mrsandipandas/Master_Thesis_Deliverables/README.md

# Master Thesis
Master Thesis Deliverables: Active Polarization Rotator (KTH-Micro and Nano Systems).

Author: Sandipan Das (sandipan@kth.se).

Supervisors: Carlos Errando Herranz(carloseh@kth.se), Phd Student at KTH, Sweden and Prof. Norvald Stol(norvald.stol@item.ntnu.no), NTNU, Norway.
             
Examiner:  Prof. Kristinn B. Gylfason(kristinn.gylfason@ee.kth.se), KTH, Sweden.

Please contact me at sandipan@kth.se if you want me to add anything.
