mrsandipandas/Master_Thesis_Deliverables/2-Thesis_Draft/Ch0.2-Title/title.tex

\documentclass[../report.tex]{subfiles}
\begin{document}	
    \begin{titlepage}
        \thispagestyle{empty}
        \begin{center}
            \\
            \vspace{2.5cm}
	            \huge{Silicon photonics based MEMS tunable}
	        \begin{adjustwidth*}{-0.1cm}{-0.1cm}
	        	\huge{polarization rotator for optical communications}\\
		    \end{adjustwidth*}
            \vspace{4cm}
            \Large{\textbf{Sandipan Das}}\\
            \vspace{4cm}
            \Large{Stockholm, \today}
        \end{center} 
        %\begin{tabular}{ll} 
        %\noindent Author: &Sandipan Das (sandipan@kth.se) \\
        %\noindent Supervisors: & Carlos Errando Herranz (carloseh@kth.se), Phd Student at %KTH, Sweden \\ 
        %					   & Prof. Norvald Stol (norvald.stol@item.ntnu.no), NTNU, Norway\\[6ex]
        %													
        %\indent Examiner:  &Prof. Kristinn B. Gylfason (kristinn.gylfason@ee.kth.se), KTH, Sweden\\ 
        %
        %\end{tabular}
    \end{titlepage}
    %Empty page inserted for making print ready 
    %\thispagestyle{empty}
    %\cleardoublepage
\end{document}
