mrsandipandas/Master_Thesis_Deliverables/2-Thesis_Draft/Ch9-Appendix/glossary.tex

\documentclass[../report.tex]{subfiles}
\begin{document}	
	
	\newacronym{iot}{IoT}{Internet of Things}
	\newacronym{ims}{IMS}{IP Multimedia Subsystem}
	\newacronym{ic}{IC}{Integrated Circuit(s)}
	\newacronym{ict}{ICT}{Information and Communication Technology}
	\newacronym{cmos}{CMOS}{Complementary Metal-Oxide Semiconductor}
	\newacronym{soi}{SOI}{Silicon on Insulator}
	\newacronym{ri}{RI}{Refractive index}
	\newacronym{mems}{MEMS}{Microelectromechanical systems}
	\newacronym{cagr}{CAGR}{Compound Annual Growth Rate}
	\newacronym{pmd}{PMD}{polarization mode dispersion}
	\newacronym{pdl}{PDL}{polarization dependent loss}
	\newacronym{pdw}{PD$\lambda$}{polarization dependent wavelength characteristics}
	\newacronym{per}{PER}{Polarization extinction ratio}
	\newacronym{pr}{PR}{Polarization Rotator}
	\newacronym{tpr}{TPR}{Tunable Polarization Rotator}
	\newacronym{tpps}{TPPS}{Tunable polarization phase shifters}
	\newacronym{sop}{SOP}{state of polarization}
	\newacronym{oeic}{OEIC}{Optoelectronic Integrated Circuit(s)}	
	\newacronym{pbg}{PBG}{Photonic band-gap}
	\newacronym{em}{EM}{Electromagnetic}
	\newacronym{tem}{TEM}{Tansverse Electromagnetic}
	\newacronym{te}{TE}{Transverse Electric}
	\newacronym{tm}{TM}{Transverse Magnetic}
	\newacronym{fem}{FEM}{Finite element method}
	\newacronym{bpm}{BPM}{Beam propagation method}
	\newacronym{fit}{FIT}{Finite integration technique}
	\newacronym{fdtd}{FDTD}{Finite difference time domain}
	\newacronym{smc}{SMC}{Single-mode condition}	
	\newacronym{rf}{RF}{Radio frequency}
	\newacronym{fom}{FOM}{figures of merit}	
	\newacronym{il}{IL}{Insertion loss}
	\newacronym{hsq}{HSQ}{Hydrogen silsesquioxane}
	\newacronym{zep}{ZEP}{ZEP7000}
	\newacronym{pbs}{PBS}{Polarization Beam Splitter}
	\newacronym{nlc}{NLC}{Nematic liquid crystals}
	\newacronym{sem}{SEM}{Scanning electron microscope}				
	
\end{document}

%from documentation
%\newacronym[⟨key-val list⟩]{⟨label ⟩}{⟨abbrv ⟩}{⟨long⟩}
%above is short version of this
% \newglossaryentry{⟨label ⟩}{type=\acronymtype,
% name={⟨abbrv ⟩},
% description={⟨long⟩},
% text={⟨abbrv ⟩},
% first={⟨long⟩ (⟨abbrv ⟩)},
% plural={⟨abbrv ⟩\glspluralsuffix},
% firstplural={⟨long⟩\glspluralsuffix\space (⟨abbrv ⟩\glspluralsuffix)},
% ⟨key-val list⟩}

% If you want to link acronym and glossary: (http://tex.stackexchange.com/questions/8946/how-to-combine-acronym-and-glossary)
%\newglossaryentry{apig}{
%	name={API},
%	description={An Application Programming Interface (API) desc}}
%\newglossaryentry{api}{
%	type=\acronymtype, 
%	name={API}, 
%	description={Application Programming Interface}, 
%	first={Application Programming Interface (API)\glsadd{apig}}, 
%	see=[Glossary:]{apig}}
