mrsandipandas/Master_Thesis_Deliverables/3-Administrative_Stuffs/Thesis_topic_form_Sandipan_Das.pdf

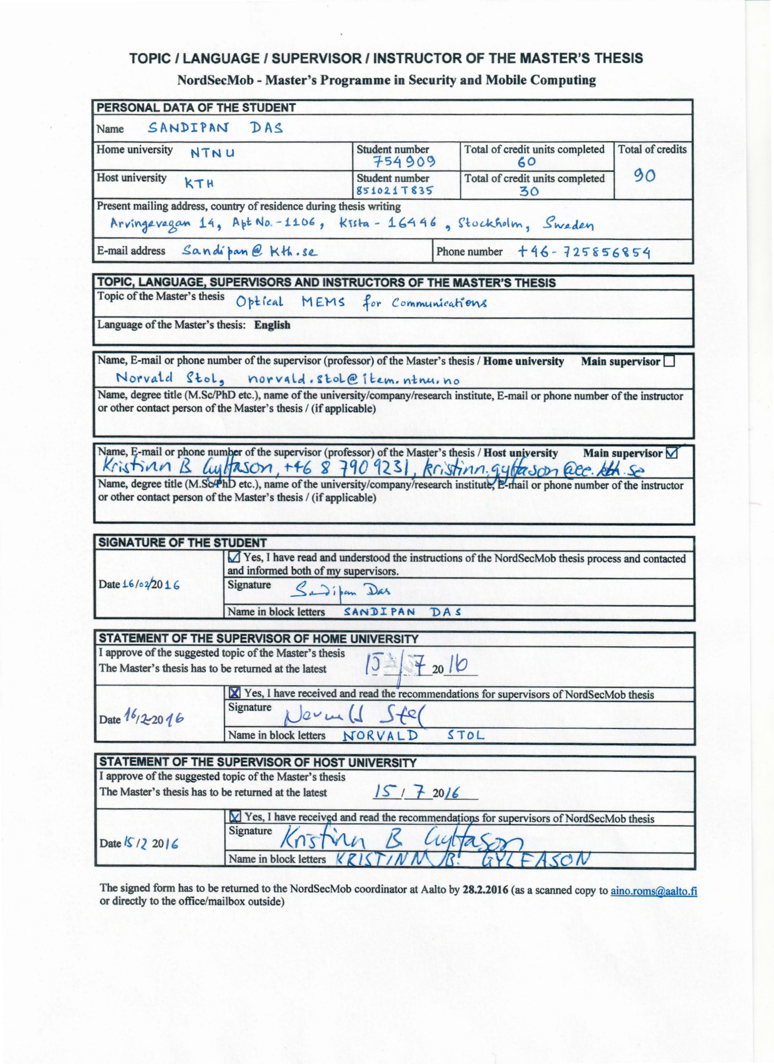
[picture p69: page 1]
