mrsandipandas/Master_Thesis_Deliverables/3-Administrative_Stuffs/Sandipan_Thesis_Application_KTH.pdf

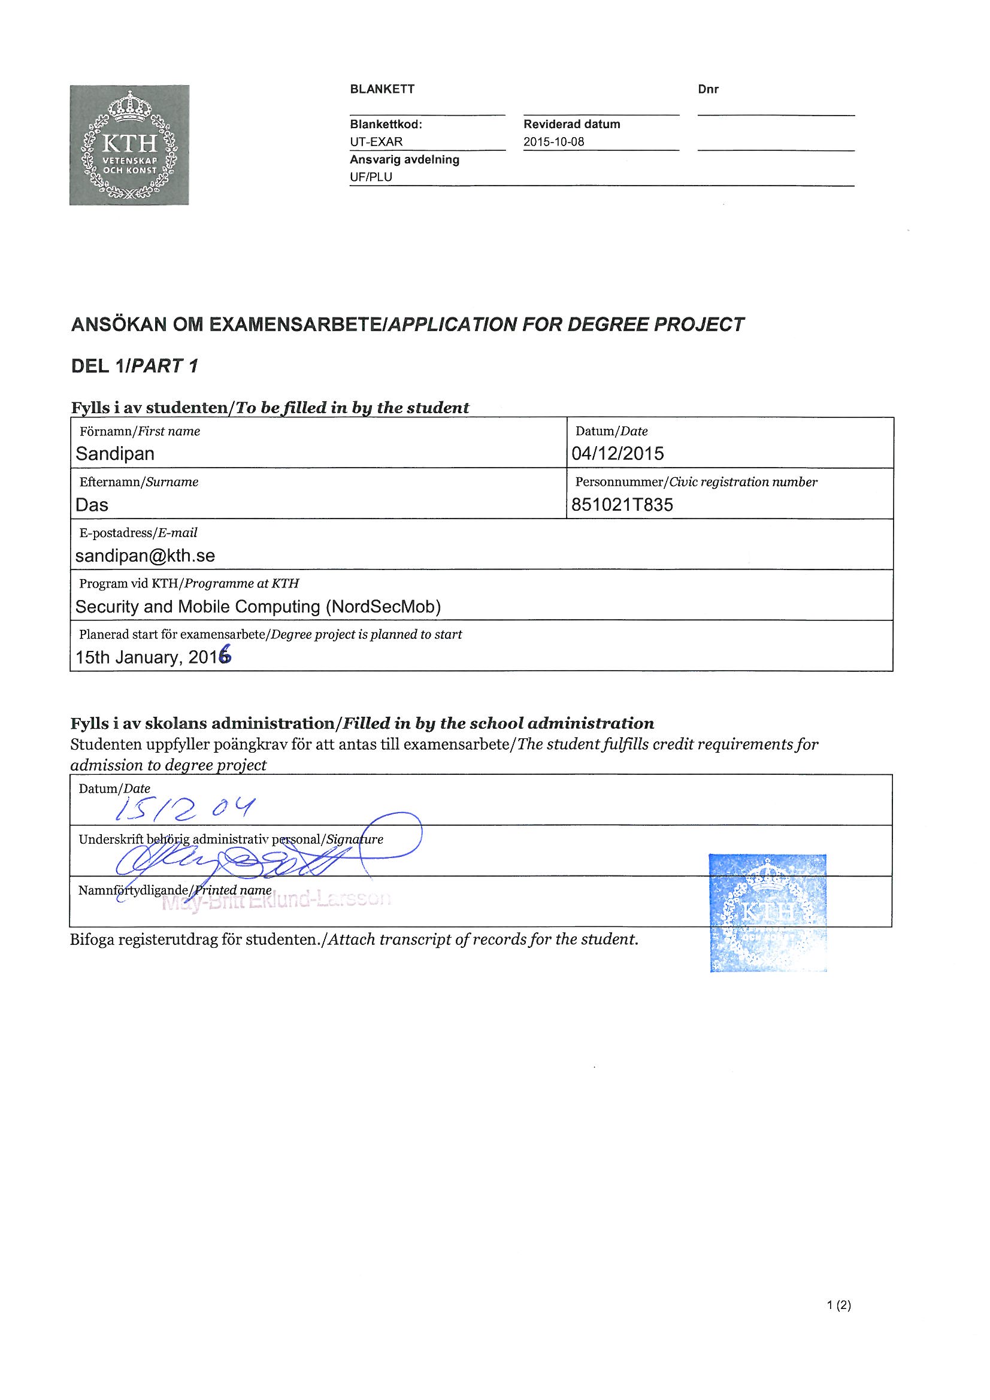
[picture p70: page 1]
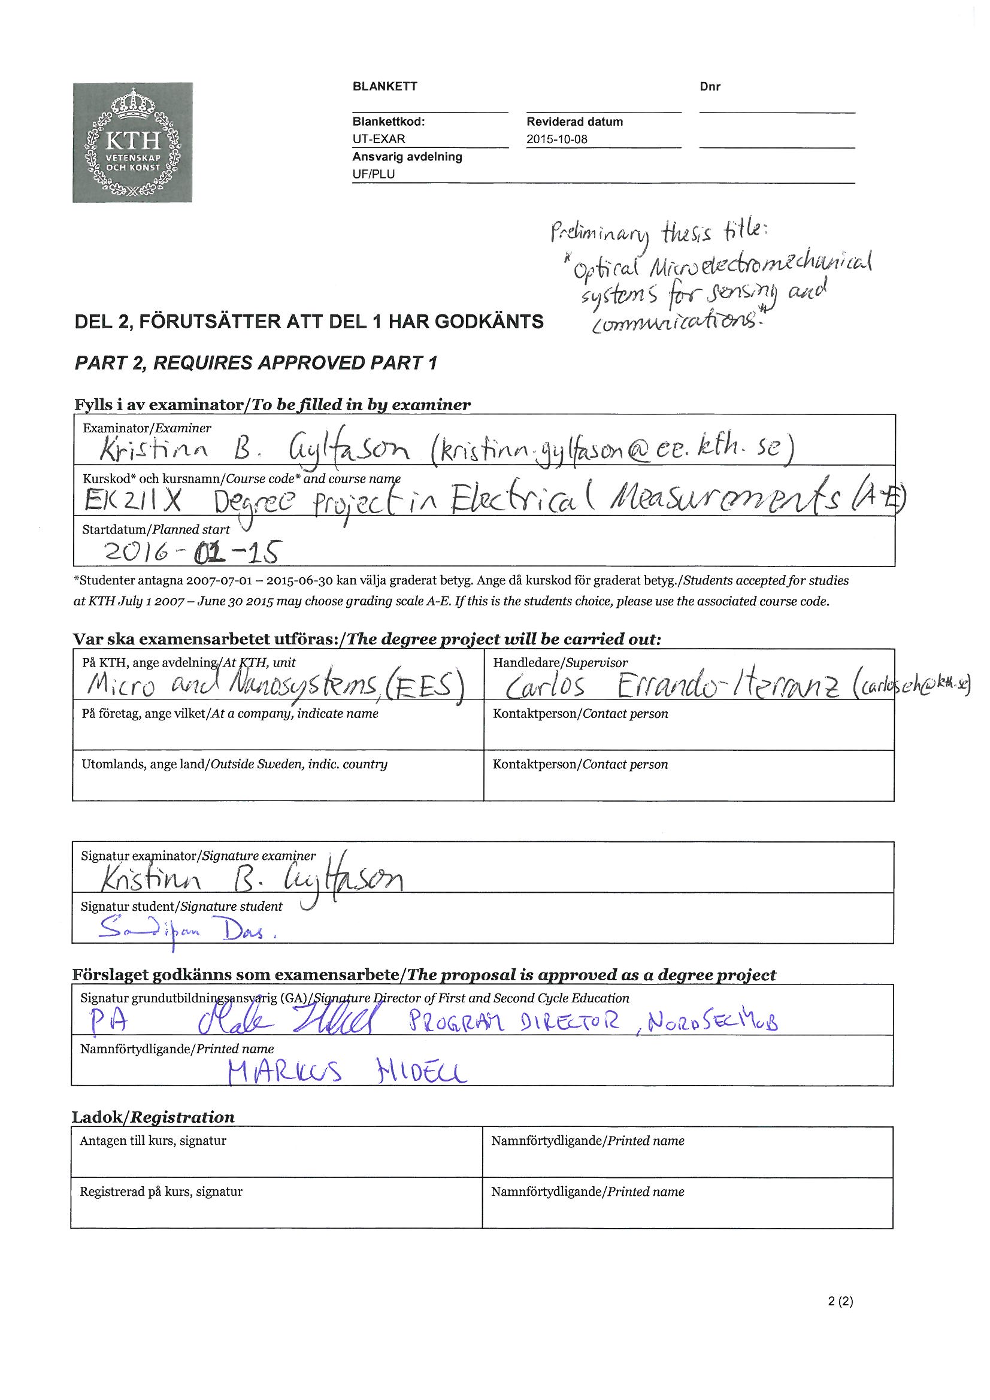
[picture p71: page 2]
