mrsandipandas/Master_Thesis_Deliverables/2-Thesis_Draft/images/pbs.xlsx

Sheet: Core_Waveguide
W_core | TE3 | TM0 | TE1 | TE0
0.30 |  | 1.046154935 |  | 1.381686723
0.32 |  | 1.058032549 |  | 1.563106257
0.34 |  | 1.071198884 |  | 1.724267958
0.36 |  | 1.084958105 |  | 1.858616204
0.38 |  | 1.100499861 |  | 1.972435758
0.40 |  | 1.116521359 | 1.00009847 | 2.065189521
0.42 |  | 1.13307403 | 1.006582029 | 2.143141025
0.44 |  | 1.14999511 | 1.015379584 | 2.209222711
0.46 |  | 1.167137372 | 1.027066121 | 2.265720223
0.48 |  | 1.184308295 | 1.042497707 | 2.314488018
0.50 |  | 1.201169659 | 1.063748212 | 2.357562383
0.52 |  | 1.217935834 | 1.092673078 | 2.394645587
0.54 |  | 1.234299599 | 1.132882844 | 2.427330579
0.56 |  | 1.250202855 | 1.188164109 | 2.456283939
0.58 |  | 1.260243649 | 1.265600932 | 2.48204625
0.60 |  | 1.280419918 | 1.346141434 | 2.505077123
0.62 |  | 1.294498793 | 1.441165934 | 2.526119869
0.64 |  | 1.308125381 | 1.533684198 | 2.544802484
0.66 |  | 1.321154999 | 1.621327276 | 2.561708667
0.68 |  | 1.333557361 | 1.702174468 | 2.577051142
0.70 |  | 1.345385022 | 1.775892896 | 2.591027862
0.72 |  | 1.356692886 | 1.84276953 | 2.603787412
0.74 |  | 1.367265523 | 1.904735656 | 2.615710186
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
