mrsandipandas/Master_Thesis_Deliverables/2-Thesis_Draft/images/1-voice-traffic-forecast.jpeg

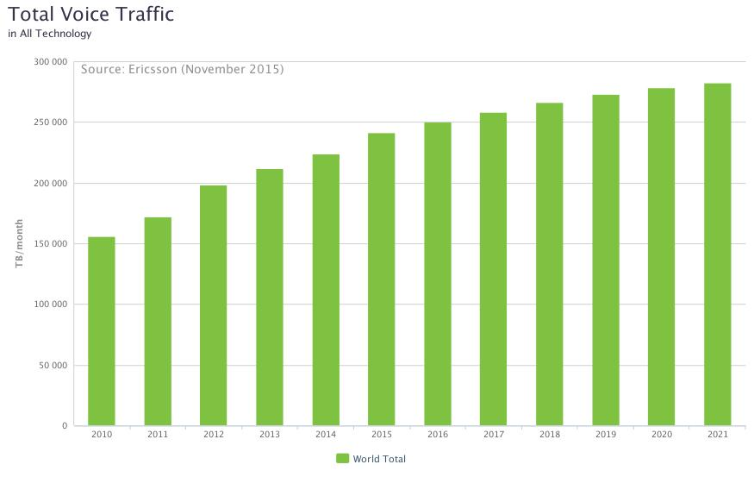
2-Thesis_Draft/images/1-voice-traffic-forecast.jpeg
