mrsandipandas/Master_Thesis_Deliverables/2-Thesis_Draft/images/2-random-pol.jpg

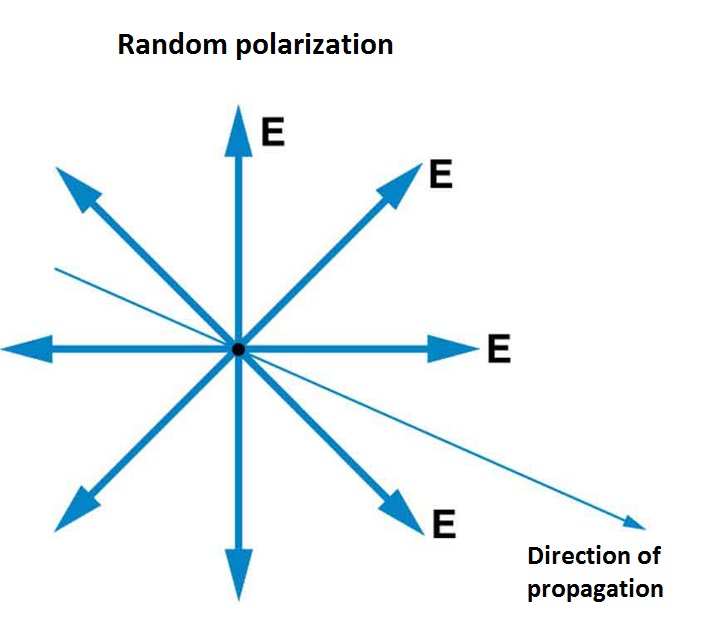
2-Thesis_Draft/images/2-random-pol.jpg
