mrsandipandas/Master_Thesis_Deliverables/2-Thesis_Draft/images/2-te-tm-mode.png

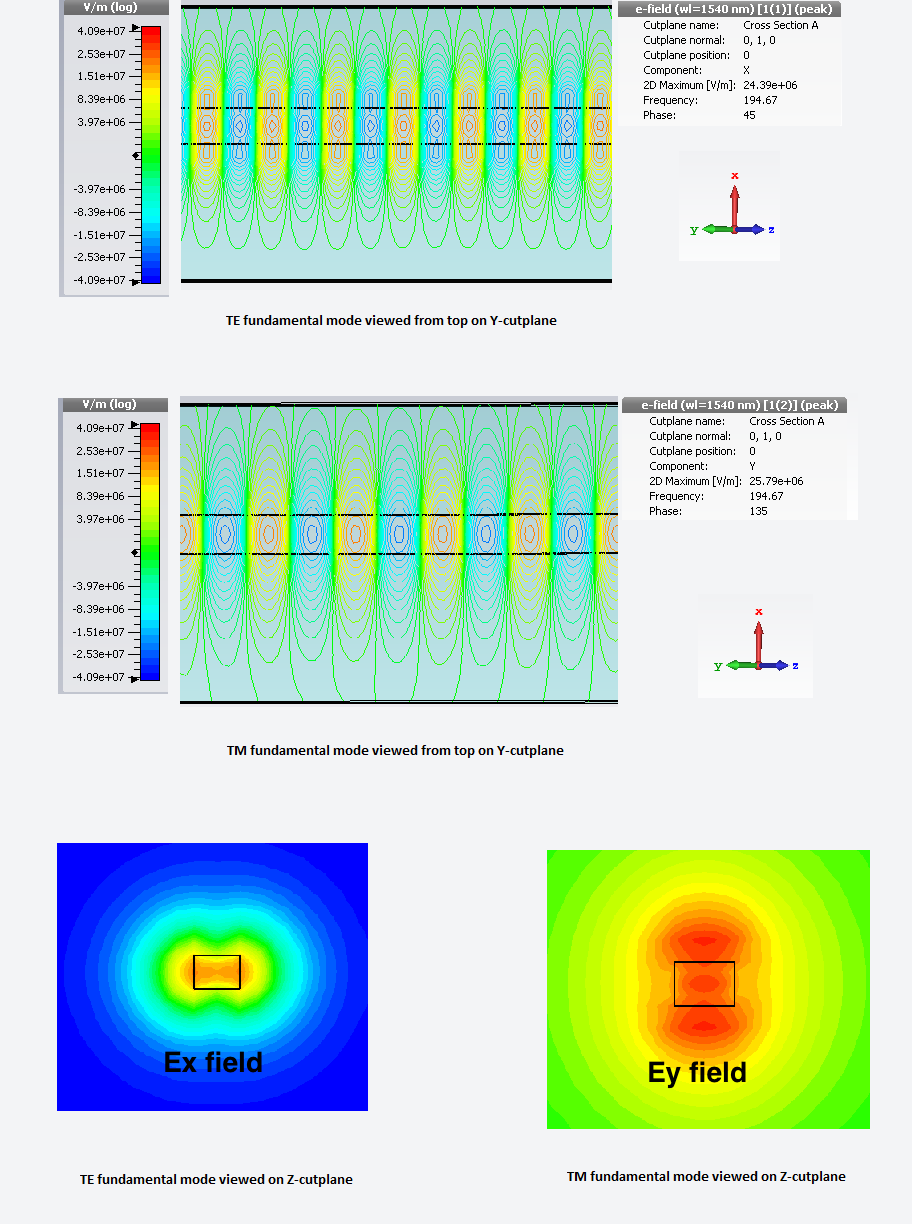
2-Thesis_Draft/images/2-te-tm-mode.png
