mrsandipandas/Master_Thesis_Deliverables/2-Thesis_Draft/images/4-tm-silica-cladding-700nm.png

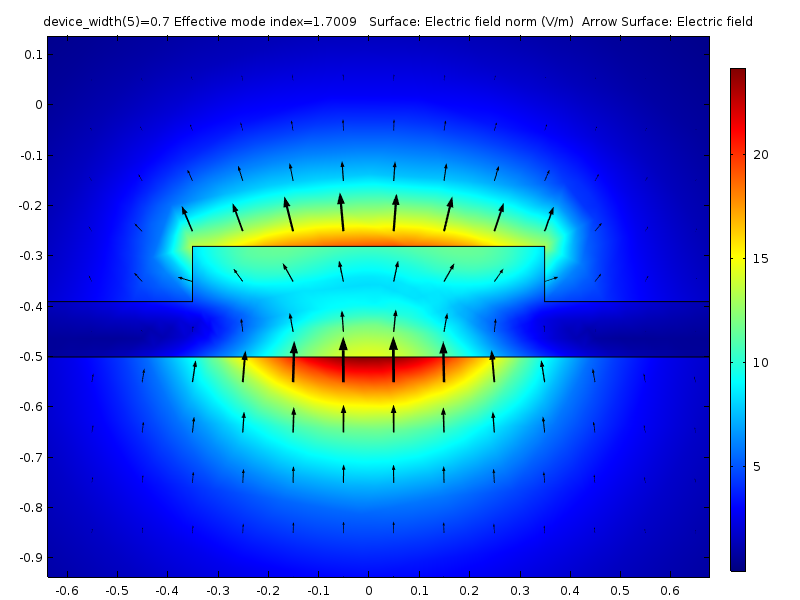
2-Thesis_Draft/images/4-tm-silica-cladding-700nm.png
