mrsandipandas/Master_Thesis_Deliverables/4-Current_work/General_idea_coupling_to_avoid_going_to_PR/c1.png

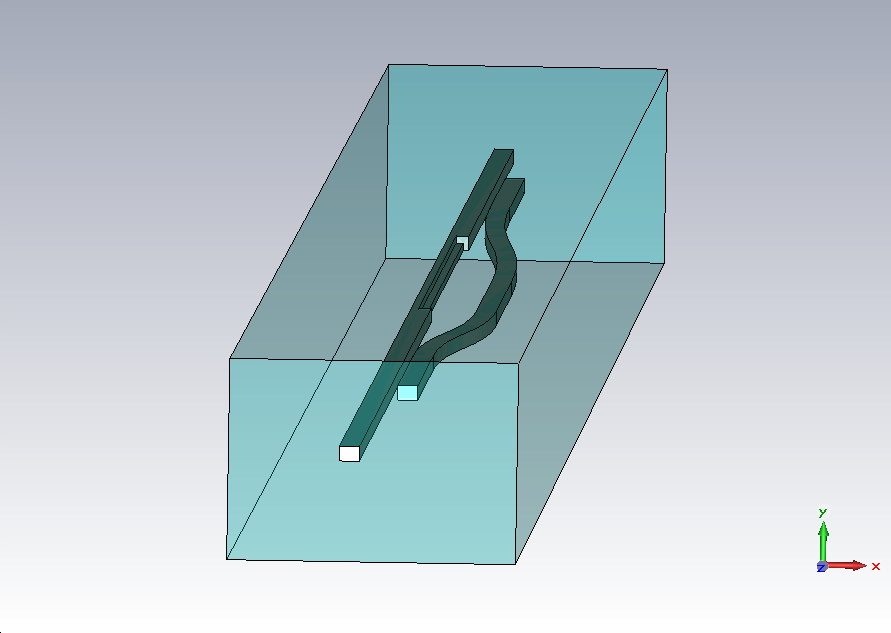
4-Current_work/General_idea_coupling_to_avoid_going_to_PR/c1.png
