mrsandipandas/Master_Thesis_Deliverables/4-Current_work/Idea_1/PR Design/1.bmp

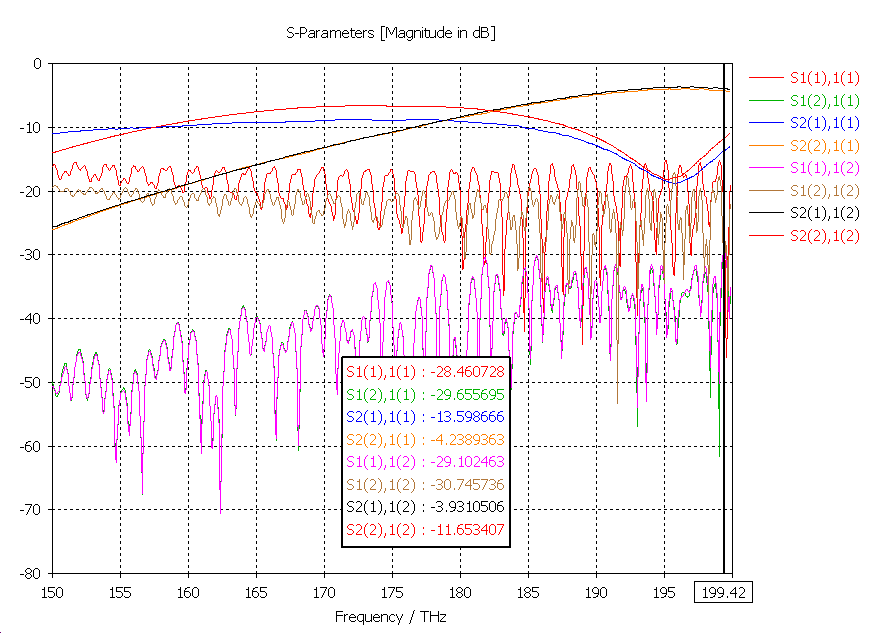
4-Current_work/Idea_1/PR Design/1.bmp
