mrsandipandas/Master_Thesis_Deliverables/4-Current_work/Idea_1/PR Design/wg.png

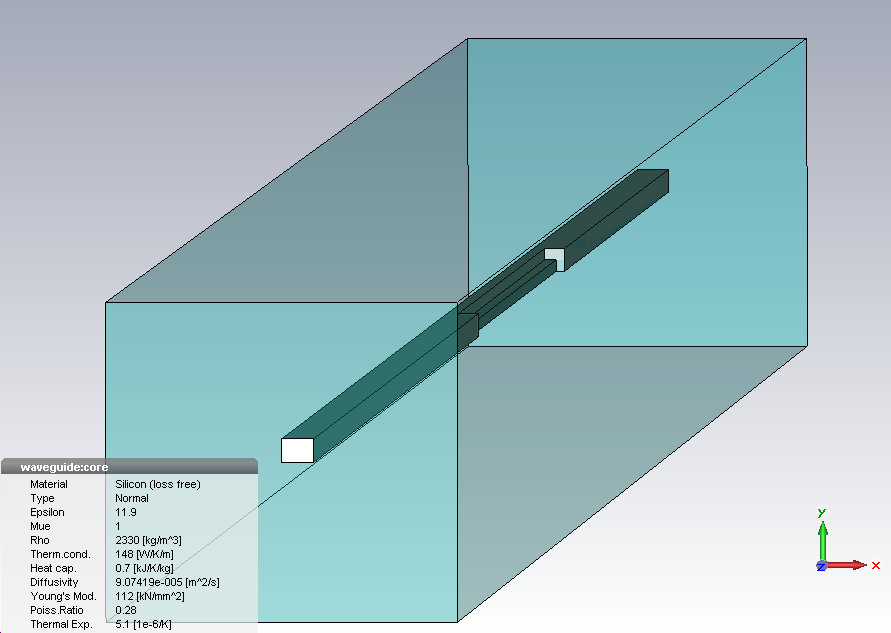
4-Current_work/Idea_1/PR Design/wg.png
