mrsandipandas/Master_Thesis_Deliverables/4-Current_work/Idea_1/PR With MEMS/stair_coupler.bmp

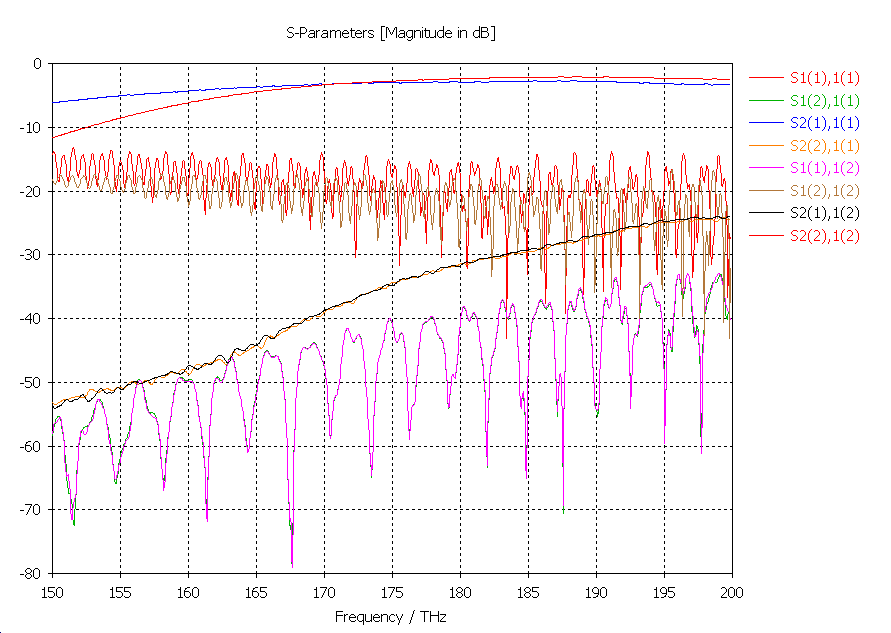
4-Current_work/Idea_1/PR With MEMS/stair_coupler.bmp
