mrsandipandas/Master_Thesis_Deliverables/4-Current_work/Idea_1/PR With MEMS/wg_with_coupling.png

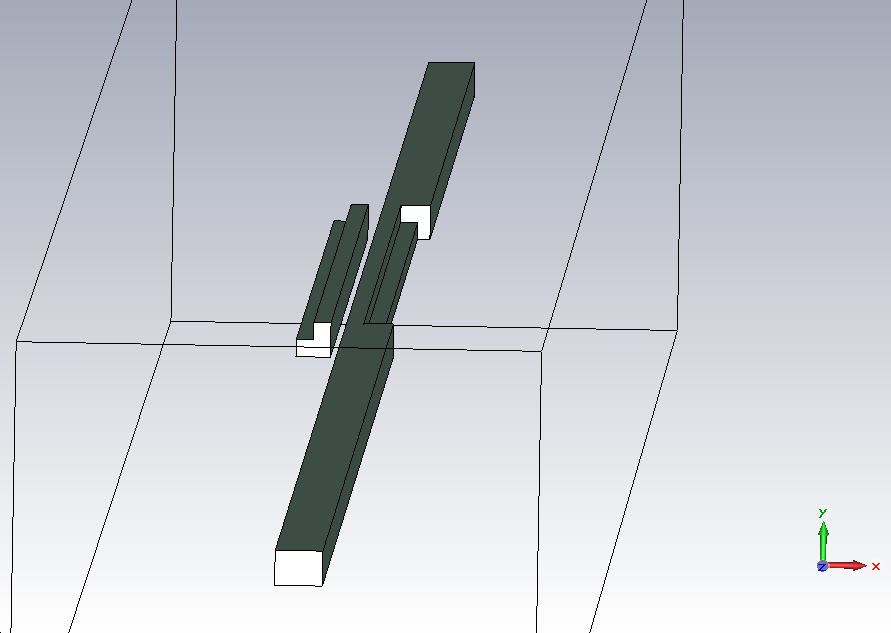
4-Current_work/Idea_1/PR With MEMS/wg_with_coupling.png
