mrsandipandas/Master_Thesis_Deliverables/4-Current_work/Idea_2/PR Design/s.bmp

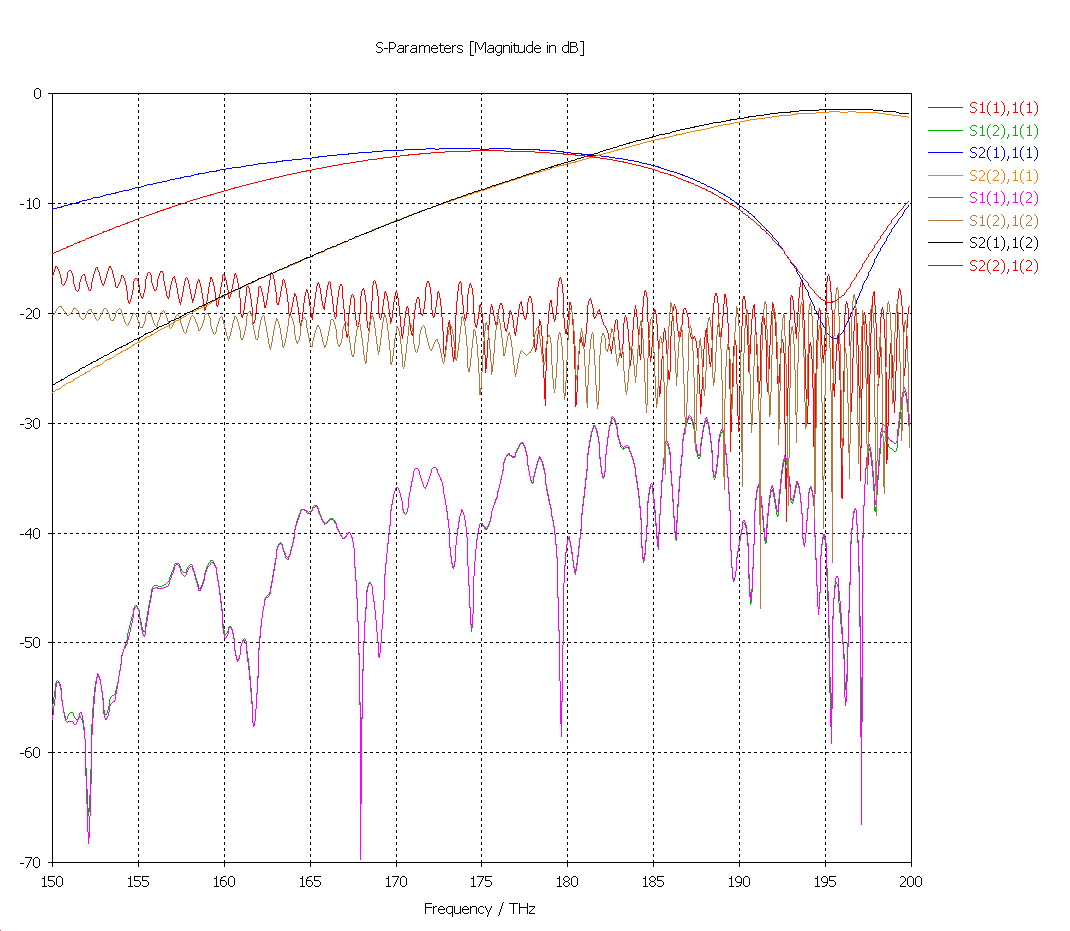
4-Current_work/Idea_2/PR Design/s.bmp
