mrsandipandas/Master_Thesis_Deliverables/4-Current_work/Idea_2/PR Design/simplewg.png

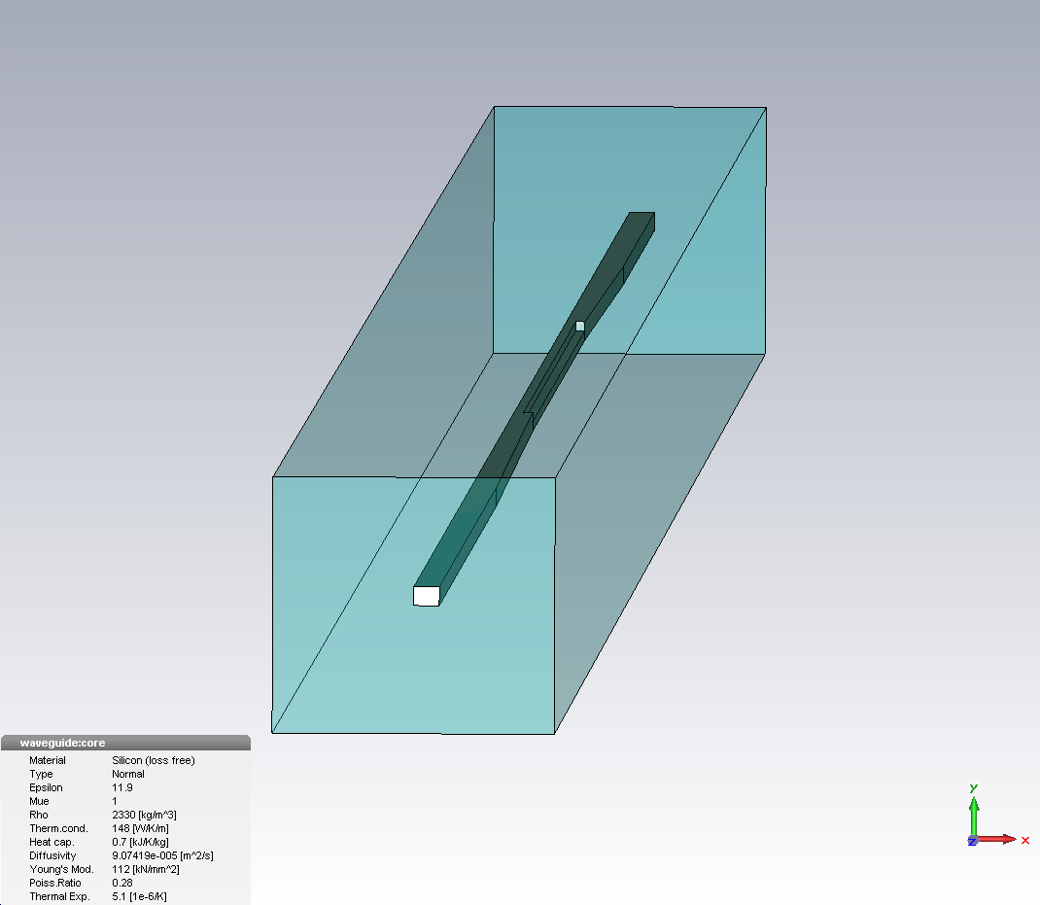
4-Current_work/Idea_2/PR Design/simplewg.png
