mrsandipandas/Master_Thesis_Deliverables/4-Current_work/Idea_2/PR With MEMS/s.bmp

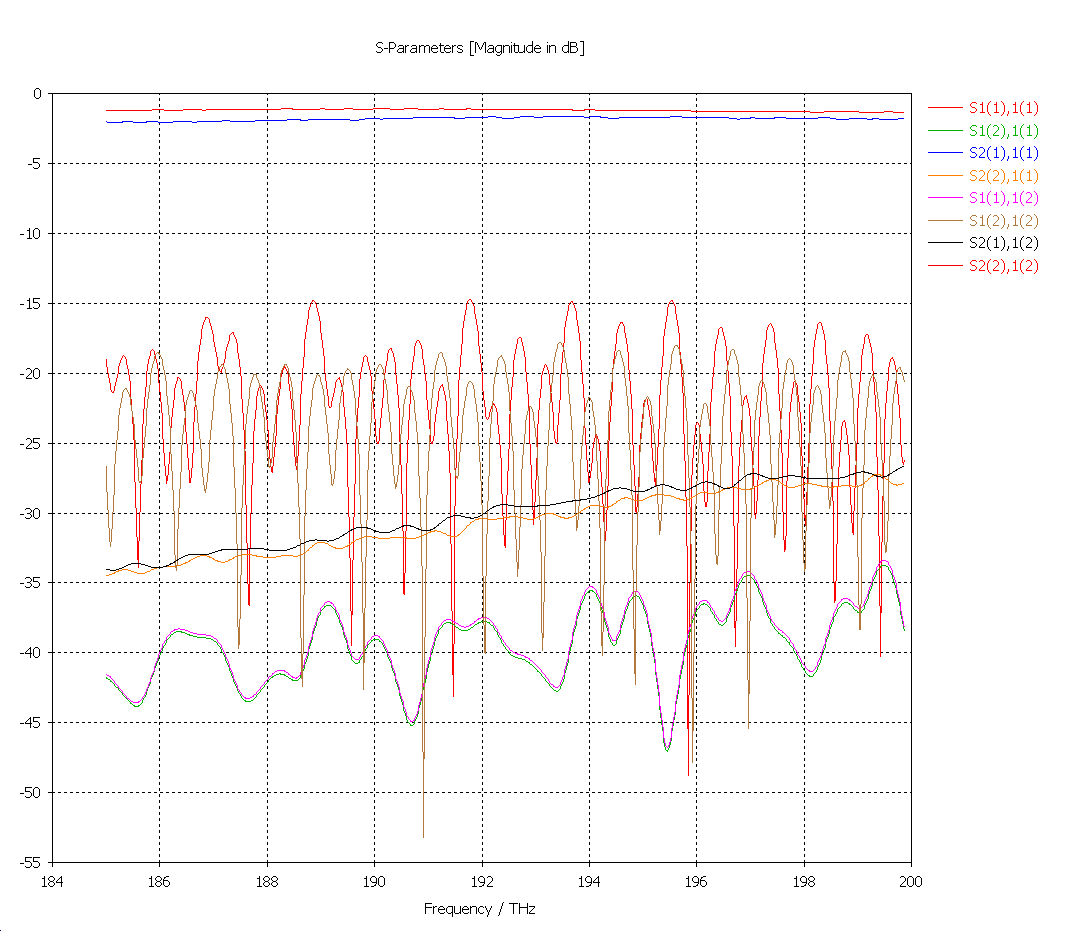
4-Current_work/Idea_2/PR With MEMS/s.bmp
