mrsandipandas/Master_Thesis_Deliverables/4-Current_work/Mode_evolution_double_taper/s.bmp

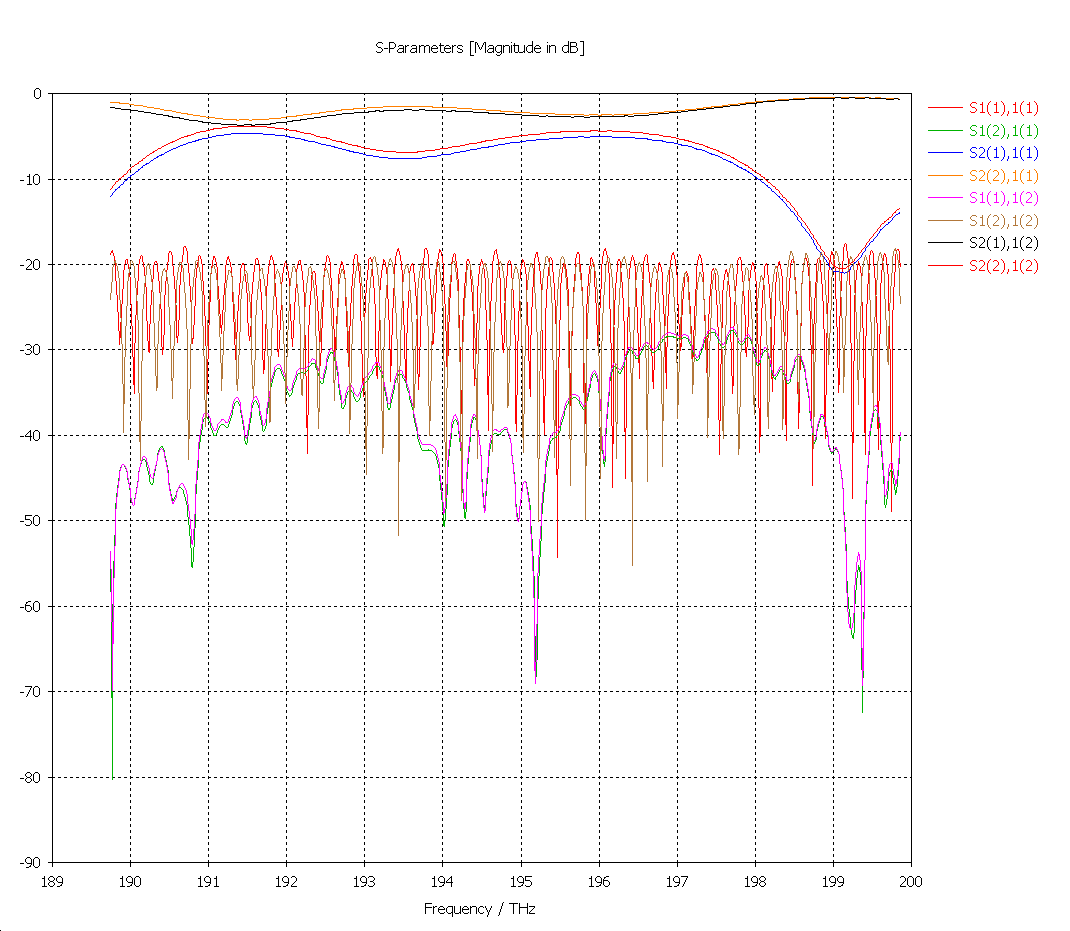
4-Current_work/Mode_evolution_double_taper/s.bmp
