mrsandipandas/Master_Thesis_Deliverables/4-Current_work/Mode_evolution_double_taper/wg.png

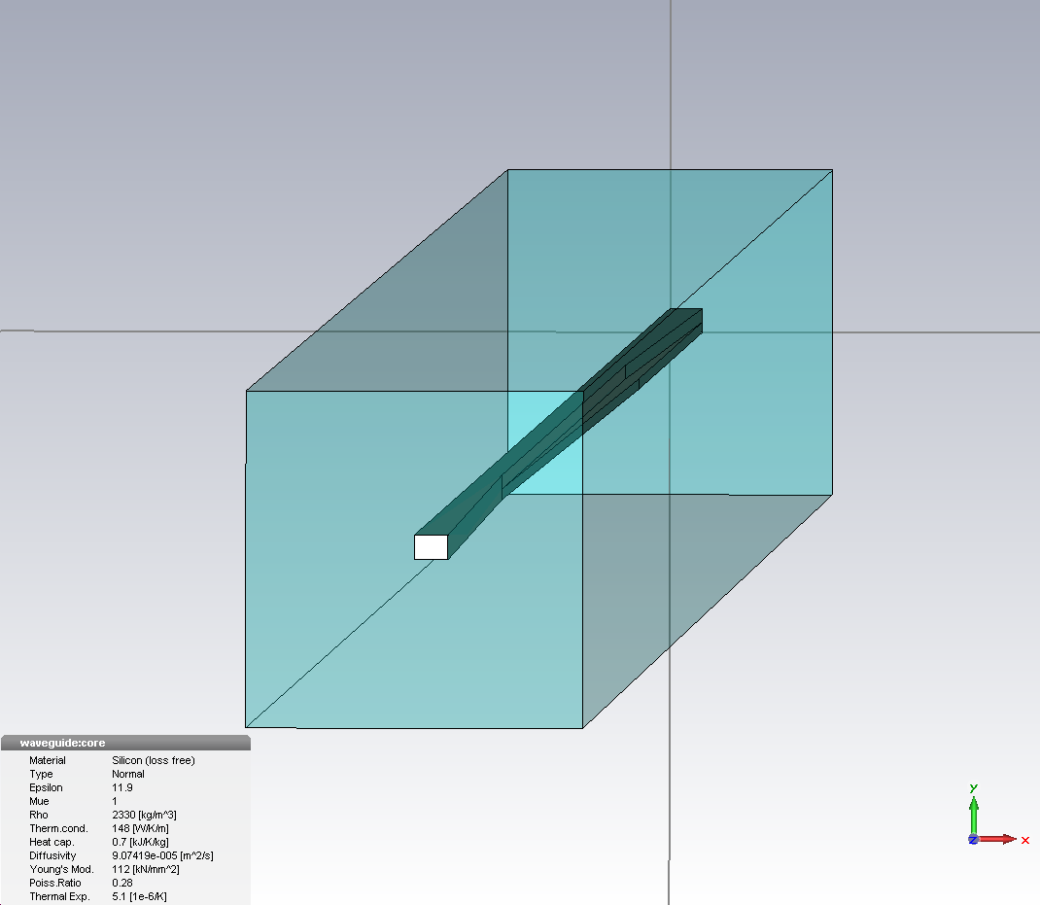
4-Current_work/Mode_evolution_double_taper/wg.png
