mrsandipandas/Master_Thesis_Deliverables/4-Current_work/Stair_idea_air_dimensions/3-graph-mode-sum.png

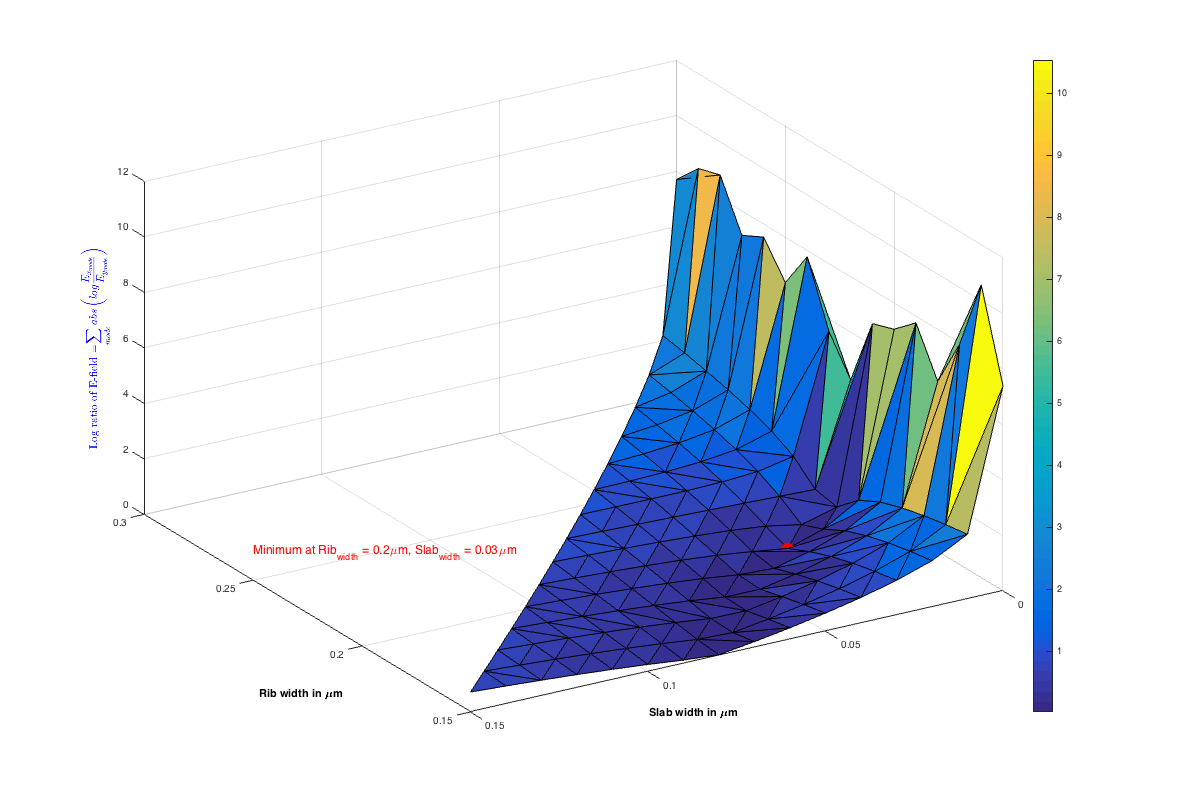
4-Current_work/Stair_idea_air_dimensions/3-graph-mode-sum.png
