mrsandipandas/Master_Thesis_Deliverables/4-Current_work/Stair_idea_air_dimensions/effective_ri.bmp

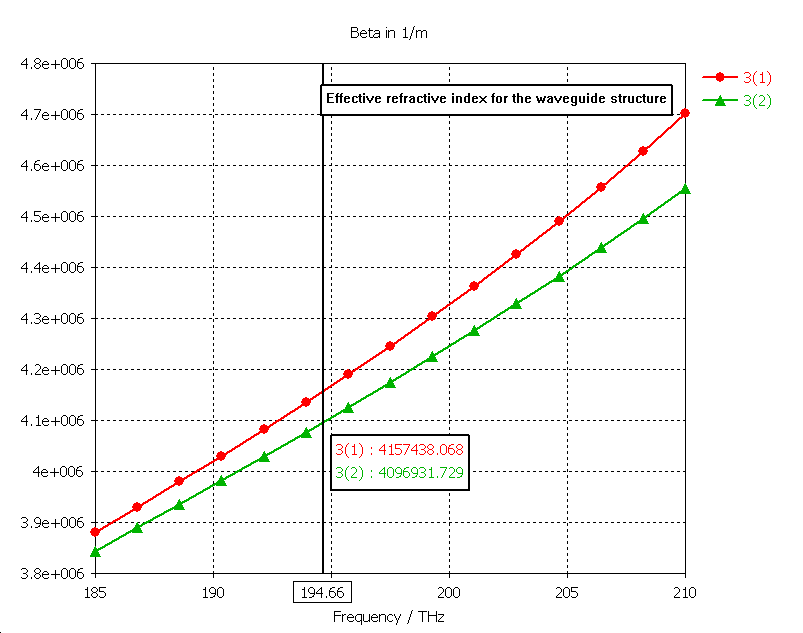
4-Current_work/Stair_idea_air_dimensions/effective_ri.bmp
