mrsandipandas/Master_Thesis_Deliverables/4-Current_work/Stair_idea_air_dimensions/mems-210-1.png

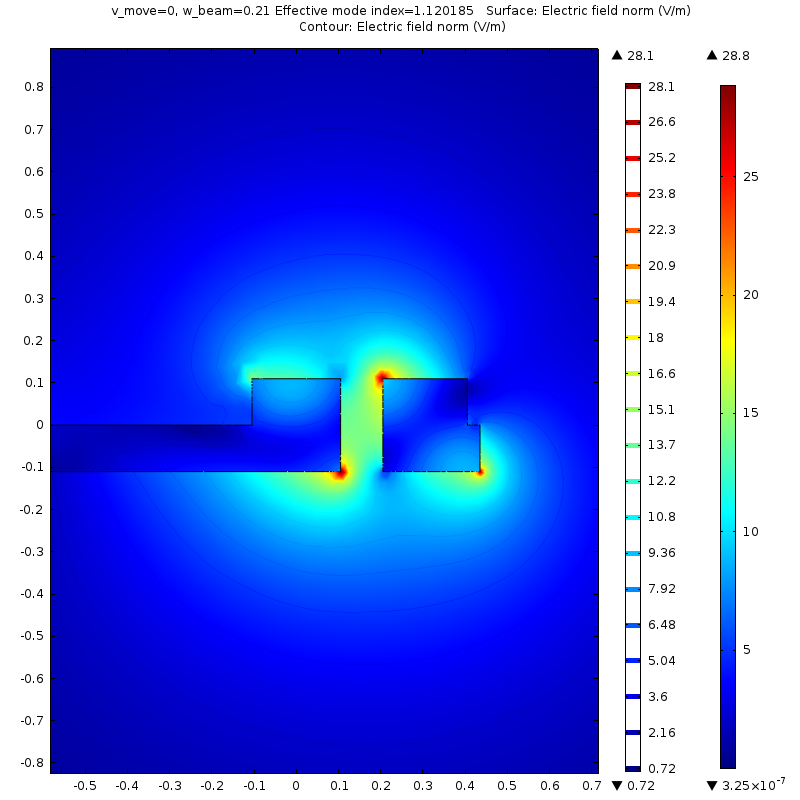
4-Current_work/Stair_idea_air_dimensions/mems-210-1.png
