mrsandipandas/Master_Thesis_Deliverables/4-Current_work/Stair_idea_air_dimensions/mems-260-1_1.png

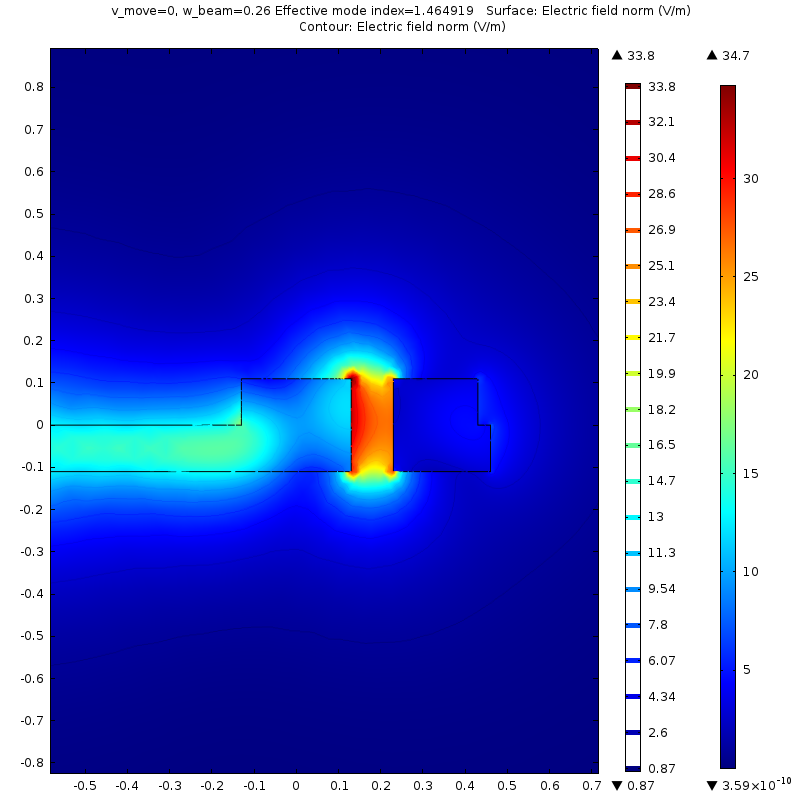
4-Current_work/Stair_idea_air_dimensions/mems-260-1_1.png
