mrsandipandas/Master_Thesis_Deliverables/4-Current_work/Stair_idea_air_dimensions/mems_graph_mode.png

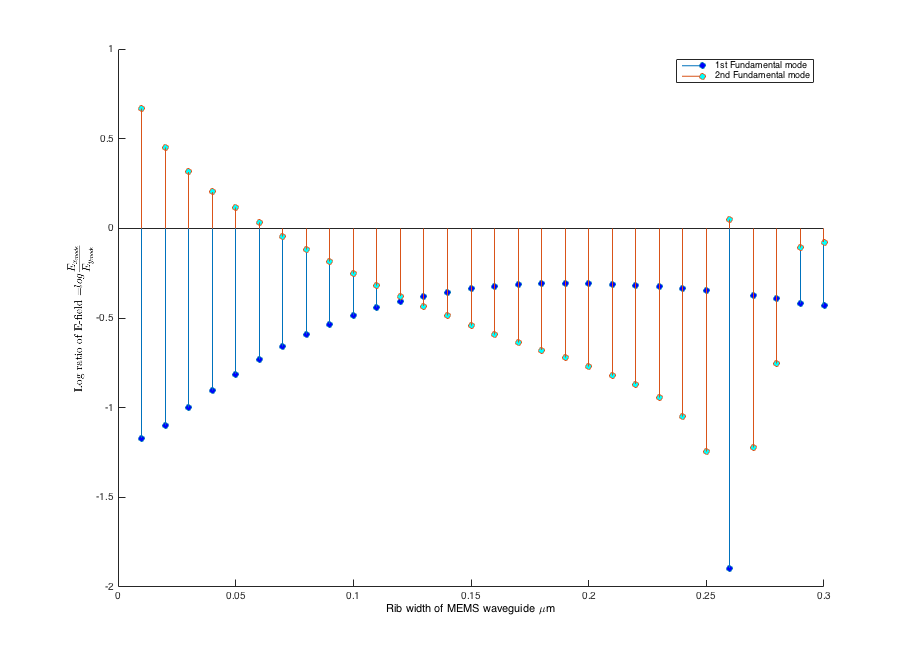
4-Current_work/Stair_idea_air_dimensions/mems_graph_mode.png
