mrsandipandas/Master_Thesis_Deliverables/4-Current_work/Stair_idea_air_dimensions/stair-s-param-230-200.bmp

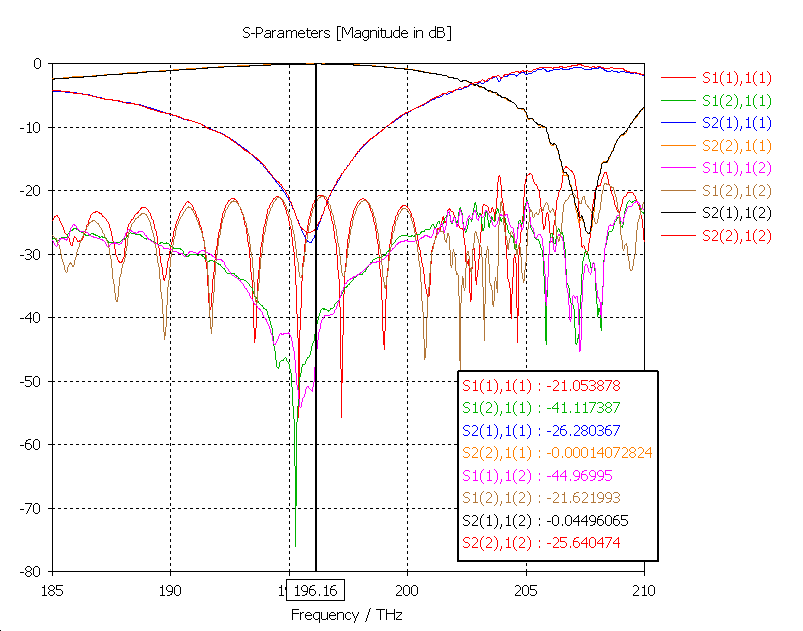
4-Current_work/Stair_idea_air_dimensions/stair-s-param-230-200.bmp
