mrsandipandas/Master_Thesis_Deliverables/4-Current_work/FOM.xlsx

Design | Dimensions | Bandwidth | PER | Insertion Loss | Material | Comments
Mode Coupling - Pg 24 in report | w_core = 0.3-1.5 mico meter, h_core = 220 nm, pr = 79-100 micro meter | 1500 - 1550nm | Conversion efficiency 90%. I have a doubt about calculating PER. 10 log(P_TM/P_TE) | 10 log (P_out/P_in) = 10 log (.9) for TM and 10 log .95 for TE at 1540nm | core - Si, upper cladding - Air/SiO2, Si3N4, bottom cladding - SiO2
Mode Evolution - Pg 25 in report | Output port: w_core = 400nm, h_core = 200nm. Input port: w_core = 200nm, h_core = 400nm, PR = 40-100 micrometer | 1530 - 1570nm | 14 - 15dB | TM - TE = 7 - 8dB, TE - TM = 2.5dB | core - Si (3.5), cladding - SiO2(1.45)
Mode Evolution - Pg 26 in report | w_core = 300nm, h_core = 220 nm, PR > 150 micro meter | 1420 - 1620nm | > 15dB | TE-TM = 0.5 dB, TM-TE = 1dB | core -Si, cladding - Sio2 | Not giving good results with air cladding, Not sure if simulation setup is done in a proper way. Results not duplicated.
Double Stair - Pg 28 in report | w_core = 320 - 360nm, h_core = 220nm, PR = 30micrometer | 1500 - 1580nm | >30dB | ~2.5dB | core-Si, cladding-SiO2
Tunable PR with Phase Shifter - Pg 29 in report | w_core = 490nm, h_core = 260nm, L_PR = 700micro meter | 1530 - 1565nm | 40dB (claiming) | <3dB | core-Si, cladding-SU-8 polymer of 5 micrometer, This makes thermal stability | 3 phase PR. Thermal effect. Can we simulate this?
Idea_2 (In attached folder) | w_core = 300nm, h_core = 220 nm, L = 100 micro meter, PR = 24.5 micrometer | 1450 - 1620nm | I have a doubt with the calculation? Need to discuss. | I have a doubt with the calculation? Need to discuss. | core - Si, cladding - SiO2 | Only simulation. Also tunable part added in the simulation design and checked. Currently, trying to adjust on this design with air cladding. Not getting super-good results.
