mrsandipandas/Master_Thesis_Deliverables/4-Current_work/General_idea_coupling_to_avoid_going_to_PR/Coupler_fabrication.png

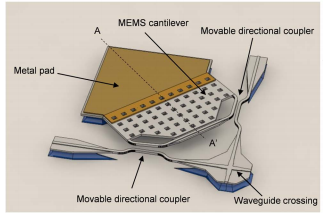
4-Current_work/General_idea_coupling_to_avoid_going_to_PR/Coupler_fabrication.png
