mrsandipandas/Master_Thesis_Deliverables/(commit log)

2016-01-22 Initial draft commit
    [Sandipan-Timeplan.xlsx]
2016-02-06 Acronym and glossary works. Install perl.exe(x86), Download xindy package,http://tex.stackexchange.com/questions/156270/has-anyone-managed-to-use-glossaries-with-texstudio-on-windows
    [Sandipan-Timeplan.xlsx]
2016-04-25 Plan updated
    [Sandipan-Timeplan.xlsx, slab-120.csv]
